adamforbes92/FISCuntrol/media/24624111478_3619f5416a_o.jpg

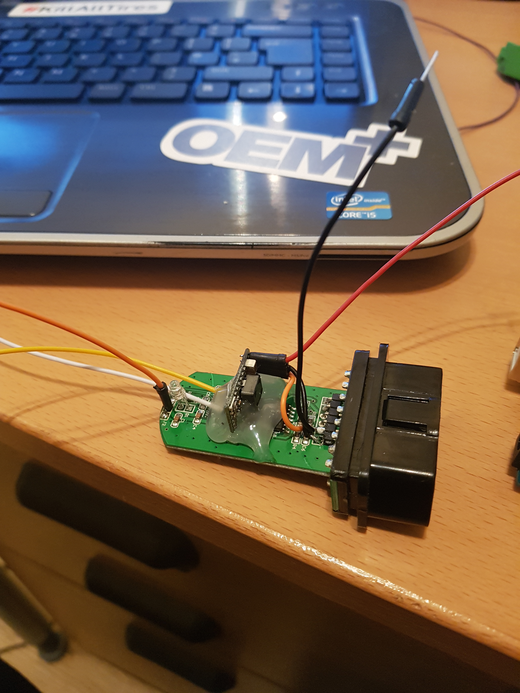
media/24624111478_3619f5416a_o.jpg
