adamforbes92/FISCuntrol/media/37781120464_9faeb15bca_o.jpg

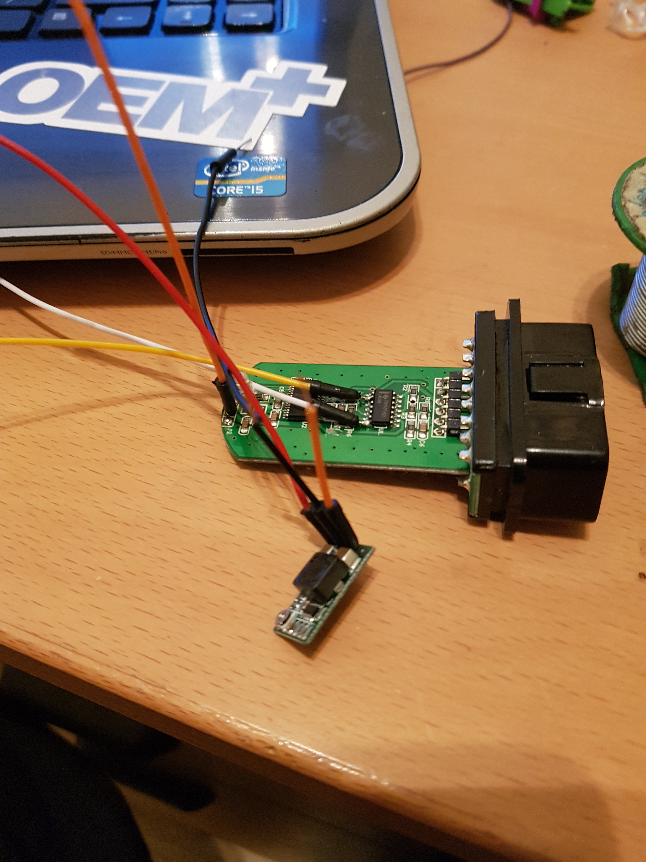
media/37781120464_9faeb15bca_o.jpg
