adamforbes92/FISCuntrol/media/38918187211_e0d8d431ef_o.jpg

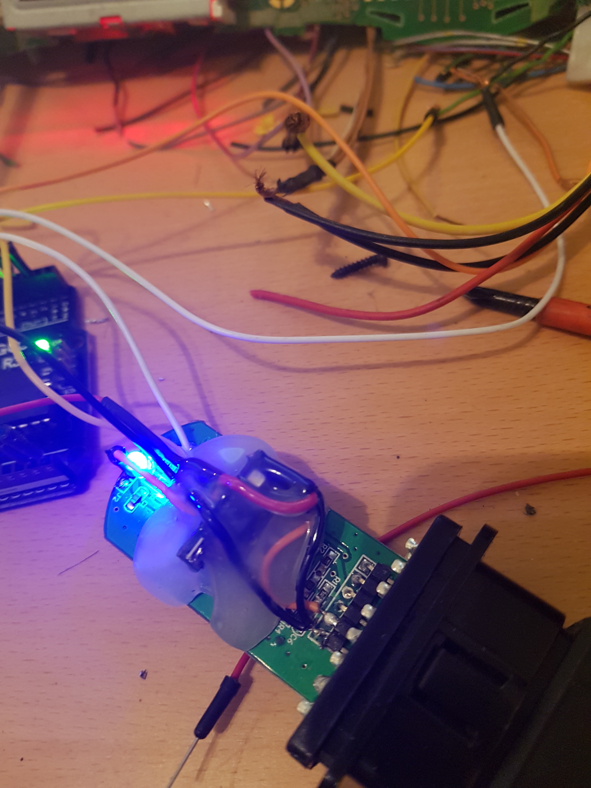
media/38918187211_e0d8d431ef_o.jpg
