adamforbes92/FISCuntrol/media/stalkWiper.png

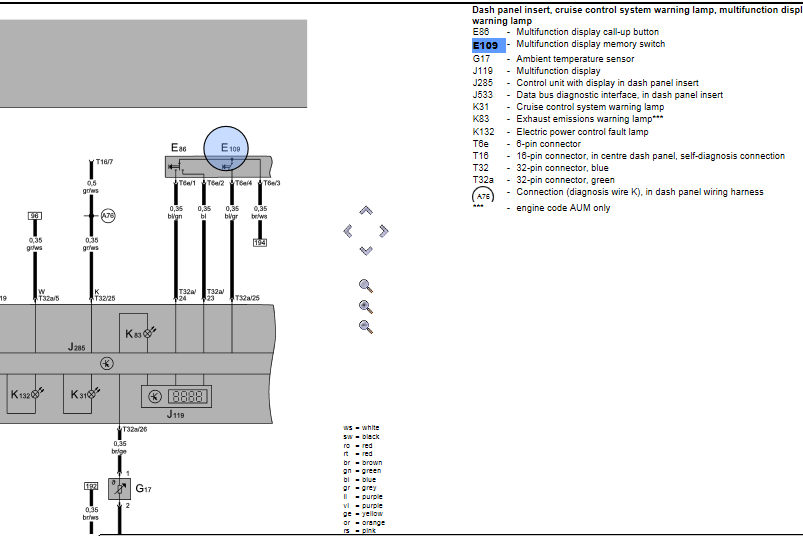
media/stalkWiper.png
