adamforbes92/FISCuntrol/media/stalkWiperCloseUp.png

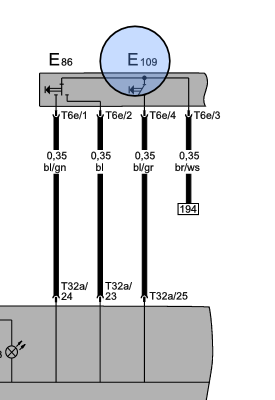
media/stalkWiperCloseUp.png
