adamforbes92/FISCuntrol/media/stalkWiperWiringDiagram.png

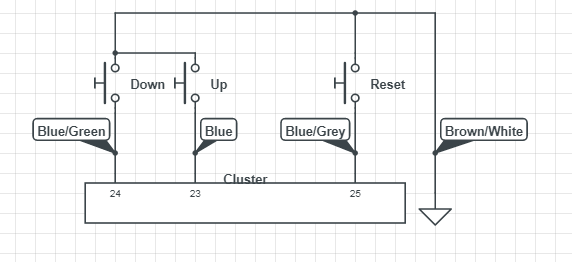
media/stalkWiperWiringDiagram.png
