adamforbes92/FISCuntrol/(threads)

Thread 1 (2017-12-11):

Add Debug Variable for Logging

jwrb, 2017-12-11:
A debug variable should be added, and all serial logging should be managed via this approach.

This will disable all serial logging unless debugging is enabled (with a variable).

Please see attached link:

[Debug Loggin on Arduino.cc](http://forum.arduino.cc/index.php?topic=155268.0)

jwrb, 2017-12-11:
`#include "Arduino.h"
 #define DEBUG true // Debugging Flag
#define Serial if(DEBUG)Serial`

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

Thread 2 (2024-05-14):

Problems with running

michalfordonski, 2024-05-14:
Hi, I like your project. I already have all the necessary elements, but I ran into a few problems.
1. Problem with resetting (I test on the table, I commented on connecting to the ECU) - Log:
 ```
16585
------connect addr=23 baud=10400
---KWP 5 baud init
bit0=0 startbit
bit1=1
bit2=1
bit3=1
bit4=0
bit5=1
bit6=0
bit7=0
bit8=1 parity
bit9=1 stopbit
---KWPReceive sz=3 blockCounter=0
IN: sz=3 data=55 1 8A
------readconnectblocks
---KWPReceive sz=0 blockCounter=1
IN: sz=16 data=F 1 F6 B1 4A 35 39 32 30 38 34 36 41 20 20 3
---KWPSendAckBlock blockCounter=2
---KWPSend sz=4 blockCounter=2
OUT:3 2 9 3
---KWPReceive sz=0 blockCounter=3
IN: sz=16 data=F 3 F6 4B 4F 4D 42 49 2B 57 45 47 46 41 48 3
---KWPSendAckBlock blockCounter=4
---KWPSend sz=4 blockCounter=4
OUT:3 4 9 3
---KWPReceive sz=0 blockCounter=5
IN: sz=15 data=E 5 F6 52 53 50 20 56 44 4F 20 56 32 30 3
---KWPSendAckBlock blockCounter=6
---KWPSend sz=4 blockCounter=6
OUT:3 6 9 3
---KWPReceive sz=0 blockCounter=7
IN: sz=9 data=8 7 F6 0 81 DE 75 3B 3
---KWPSendAckBlock blockCounter=8
---KWPSend sz=4 blockCounter=8
OUT:3 8 9 3
---KWPReceive sz=0 blockCounter=9
IN: sz=4 data=3 9 9 3
label=�J5920846A KOMBI+WEGFARSP VDO V2
Disabled.  Force pins HIGH
Return & Display Boot Message
```
The effect is that every now and then there is Welcome Adam!, Connecting to cluster 1/3, and reset (message from cluster: Immo. Activated)

2. Could you write more about connecting the buttons (Pins 4,5,6) and the ignition (pin 7)? I.e. more specifically, what voltage should go to the pins - 12v, 5v, ground?
