adamforbes92/FISCuntrol/VWbitmaps.h

uint8_t avant[138] = {
0x07,0xfe,0x00
,0x3f,0xff,0xc0
,0x78,0x01,0xe0
,0xc8,0x01,0x30
,0xb4,0x02,0xd0
,0xc4,0x02,0x30
,0x84,0x02,0x10
,0x84,0x02,0x10
,0x84,0x02,0x10
,0x84,0x02,0x10
,0x84,0x02,0x10
,0x9f,0xff,0x90
,0xb0,0x00,0xd0
,0xe0,0x00,0x70
,0x80,0x00,0x10
,0x80,0x00,0x10
,0x80,0x00,0x10
,0xe0,0x00,0x70
,0xb7,0xfe,0xd0
,0x98,0x01,0x90
,0x90,0x00,0x90
,0x90,0x00,0x90
,0x90,0x00,0x90
,0x90,0x00,0x90
,0x90,0x00,0x90
,0xf0,0x00,0xf0
,0x90,0x00,0x90
,0x90,0x00,0x90
,0x90,0x00,0x90
,0x90,0x00,0x90
,0x90,0x00,0x90
,0x90,0x00,0x90
,0x90,0x00,0x90
,0xb0,0x00,0xd0
,0xd0,0x00,0xb0
,0x90,0x00,0x90
,0x90,0x00,0x90
,0x90,0x00,0x90
,0x90,0x00,0x90
,0x98,0x01,0x90
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

  };

uint8_t sedan[138] = {
0x07,0xfe,0x00
,0x3f,0xff,0xc0
,0x78,0x01,0xe0
,0xc8,0x01,0x30
,0xb4,0x02,0xd0
,0xc4,0x02,0x30
,0x84,0x02,0x10
,0x84,0x02,0x10
,0x84,0x02,0x10
,0x84,0x02,0x10
,0x84,0x02,0x10
,0x9f,0xff,0x90
,0xb0,0x00,0xd0
,0xe0,0x00,0x70
,0x80,0x00,0x10
,0x80,0x00,0x10
,0x80,0x00,0x10
,0xe0,0x00,0x70
,0xb7,0xfe,0xd0
,0x98,0x01,0x90
,0x90,0x00,0x90
,0x90,0x00,0x90
,0x90,0x00,0x90
,0x90,0x00,0x90
,0x90,0x00,0x90
,0xf0,0x00,0xf0
,0x90,0x00,0x90
,0x90,0x00,0x90
,0x90,0x00,0x90
,0x90,0x00,0x90
,0x90,0x00,0x90
,0x90,0x00,0x90
,0x90,0x00,0x90
,0xb8,0x01,0xd0
,0xe7,0xfe,0x70
,0x80,0x00,0x10
,0xc0,0x00,0x30
,0xa0,0x00,0x50
,0x90,0x00,0x90
,0x8c,0x03,0x10
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
};

uint8_t left_door[8] = {
0x02
,0x07
,0x0c
,0x18
,0x30
,0x63
,0xc5
,0x79
};

uint8_t right_door[8] {
0xc0
,0xe0
,0x30
,0x18
,0x0c
,0xc6
,0xa3
,0x9e
};

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
,0xe0,0x07,0x1c,0x3c,0x07,0x9d,0xc7,0x70
,0xf0,0x07,0x1c,0x1c,0x03,0xdf,0x87,0xe0
,0x78,0x0f,0x1c,0x1c,0x01,0xdf,0x87,0xe0
,0x7c,0x3e,0x1c,0x3c,0x83,0xcf,0x07,0xc0
,0x3f,0xff,0xdf,0xfd,0xff,0x8f,0x07,0xc0
,0x0f,0xff,0xdf,0xf9,0xff,0x0e,0x03,0x80
,0x01,0xff,0x9f,0xc0,0x7e,0x0e,0x03,0x80
   };
