adamforbes92/FISCuntrol/(commit log)

2017-12-08 V1.15
    Now with added buttons.
2018-08-20 Mega Version 1
    Now with Mega, stalk buttons working, boot logos close.
